InfraredAces/GP2040-CE-Hardware/GP2040 Keyboard Converter/PCB-embedded/assets/PCB-3D.png

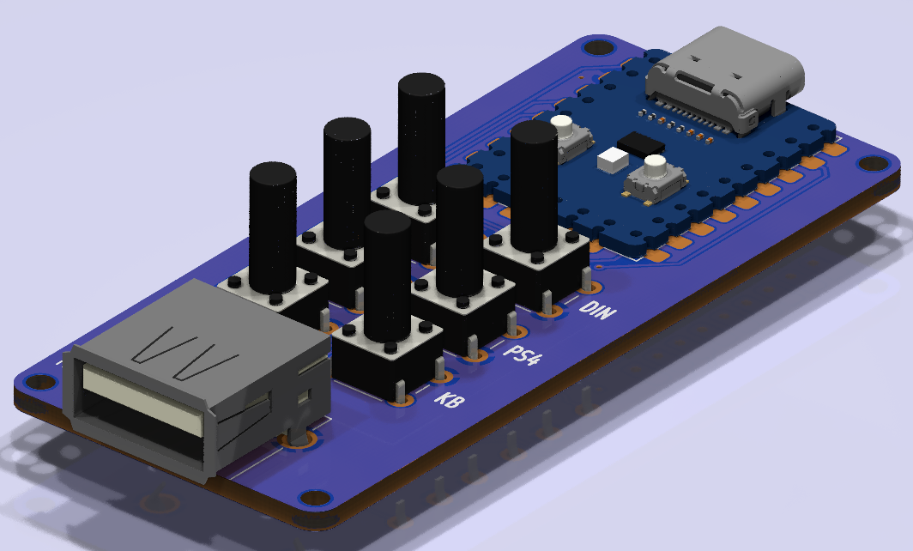
GP2040 Keyboard Converter/PCB-embedded/assets/PCB-3D.png
