InfraredAces/GP2040-CE-Hardware/GP2040 Keyboard Converter/PCB-embedded/case/GP2040-CE Converter Embedded - Bottom.step

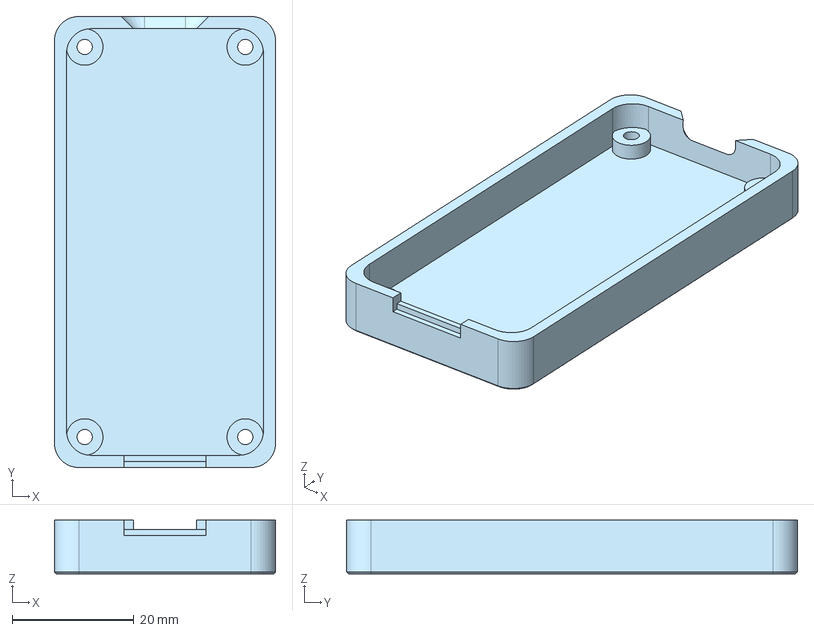
[picture p6: CAD file, 2023-08-12]
GP2040 Keyboard Converter/PCB-embedded/case/GP2040-CE Converter Embedded - Bottom.step
36.3 x 74.0 x 8.80 mm
