InfraredAces/GP2040-CE-Hardware/GP2040 Keyboard Converter/PCB-embedded/kicad/SMF05CT1G/SMF05CT1G.step

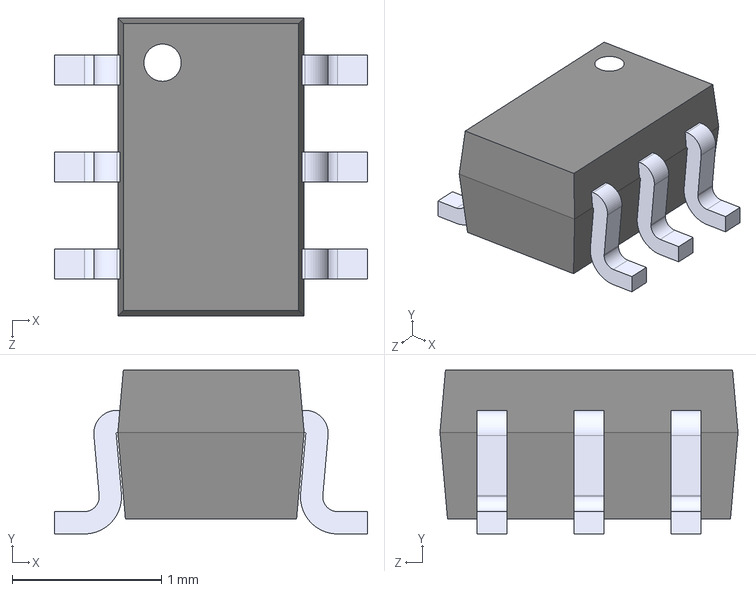
[picture p7: CAD file, 2023-08-12]
GP2040 Keyboard Converter/PCB-embedded/kicad/SMF05CT1G/SMF05CT1G.step
2.10 x 1.10 x 2.00 mm
