InfraredAces/GP2040-CE-Hardware/GP2040 Keyboard Converter/PCB-embedded/case/GP2040-CE Converter Embedded - Top.step

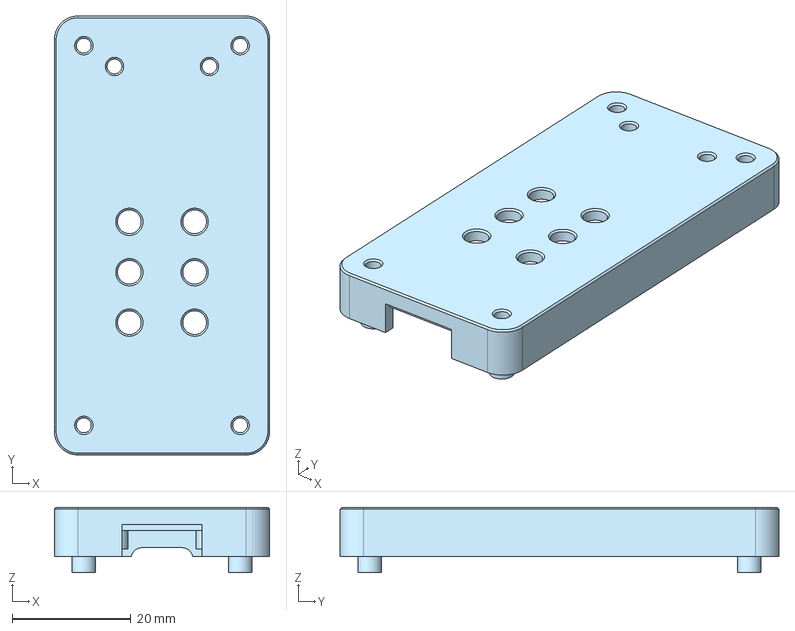
[picture p8: CAD file, 2023-08-12]
GP2040 Keyboard Converter/PCB-embedded/case/GP2040-CE Converter Embedded - Top.step
36.3 x 74.0 x 11.0 mm
