InfraredAces/GP2040-CE-Hardware/(list of files, cad)

Other CAD files:
GP2040 Keyboard Converter/PCB-embedded/case/GP2040-CE Converter Embedded - Bottom.3mf
GP2040 Keyboard Converter/PCB-embedded/case/GP2040-CE Converter Embedded - Bottom.stl
GP2040 Keyboard Converter/PCB-embedded/case/GP2040-CE Converter Embedded - Top.3mf
GP2040 Keyboard Converter/PCB-embedded/case/GP2040-CE Converter Embedded - Top.stl
