InfraredAces/GP2040-CE-Hardware/GP2040 Keyboard Converter/PCB-embedded/kicad/GP2040-Converter.kicad_pcb

## KiCad design GP2040 Keyboard Converter/PCB-embedded/kicad/GP2040-Converter.kicad_pcb (2023-08-12)

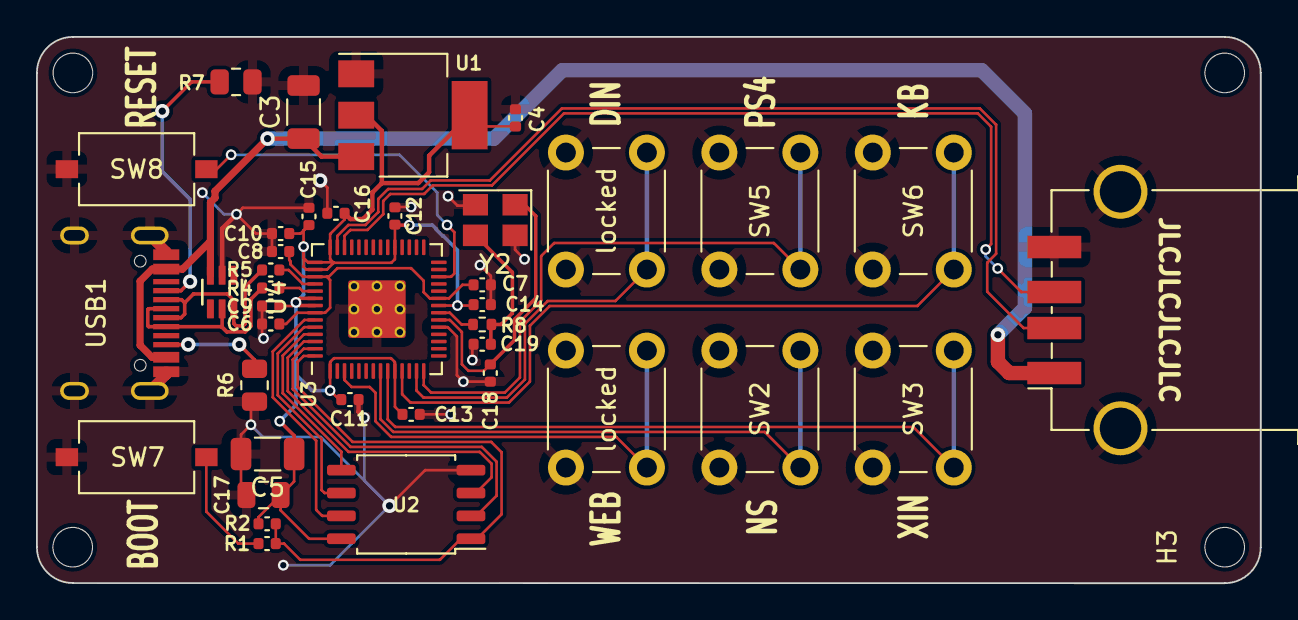
[picture p9: board GP2040-Converter.kicad_pcb from above]

Board: 2 copper layers, 68.0 x 30.4 mm, 43 parts (0 on the bottom side), 29 nets.

Parts:
C3, C5: 10u; C_1206_3216Metric
C4, C6, C7, C9, C11, C12, C13, C14, C15, C16: 100n; C_0402_1005Metric
C8, C10: 1u; C_0402_1005Metric
C17: 10u; C_0805_2012Metric
C18, C19: 30p; C_0402_1005Metric
H1, H2, H3, H4: MountingHole; MountingHole_2.2mm_M2
J1: USB_A; USB_A_TE_292303-7_Horizontal
R1: 1k; C_0402_1005Metric
R2: 10k; C_0402_1005Metric
R4, R5: 27; C_0402_1005Metric
R6, R7: 5.1k; R_0805_2012Metric
R8: 1k; R_0402_1005Metric
SW2, SW3, SW5, SW6: SW_Push_Open; SW_PUSH_6mm_H13mm
SW7, SW8: SW_Push_Open; SW_Tactile_SPST_NO_Straight_CK_PTS636Sx25SMTRLFS
U1: NCP1117-3.3_SOT223; SOT-223-3_TabPin2
U2: W25Q128JVS; SOIC-8_5.23x5.23mm_P1.27mm
U3: RP2040; RP2040-QFN-56
U4: SMF05CT1G; SOT65P210X110-6N
USB1: HRO-TYPE-C-31-M-12; HRO-TYPE-C-31-M-12-Assembly
Y2: Crystal_GND24; Crystal_SMD_3225-4Pin_3.2x2.5mm
locked: locked; SW_PUSH_6mm_H13mm
locked#2: SW_Push_Open; SW_PUSH_6mm_H13mm

Connections:
+1V1: C6.1, C7.1, C8.1, U3.23 (DVDD), U3.45 (VREG_VOUT), U3.50 (DVDD)
+3V3: C4.1, C5.1, C9.1, C10.1, C11.1, C12.1, C13.1, C14.1, C15.1, C16.1, C17.1, R2.1, U1.2 (VO), U2.8 (VCC), U3.1 (IOVDD), U3.10 (IOVDD), U3.22 (IOVDD), U3.33 (IOVDD), U3.42 (IOVDD), U3.43 (ADC_AVDD), U3.44 (VREG_IN), U3.48 (USB_VDD), U3.49 (IOVDD)
+5V: C3.1, J1.1 (VBUS), U1.3 (VI), U4.3, USB1.2 (VBUS), USB1.11 (VBUS)
/QSPI_SCLK: U2.6 (CLK), U3.52 (QSPI_SCLK)
/QSPI_SD0: U2.5 (DI(IO0)), U3.53 (QSPI_SD0)
/QSPI_SD1: U2.2 (DO(IO1)), U3.55 (QSPI_SD1)
/QSPI_SD2: U2.3 (IO2), U3.54 (QSPI_SD2)
/QSPI_SD3: U2.7 (IO3), U3.51 (QSPI_SD3)
/QSPI_SS: R1.1, R2.2, U2.1 (~CS), U3.56 (QSPI_SS)
/RUN: SW8.2 (B), U3.26 (RUN)
/USB_D+: R4.1, U4.5, USB1.6 (DP1), USB1.8 (DP2)
/USB_D-: R5.1, U4.6, USB1.5 (DN2), USB1.7 (DN1)
/XIN: C18.2, U3.20 (XIN), Y2.1
/XOUT: R8.2, U3.21 (XOUT)
/~USB_BOOT: R1.2, SW7.2 (B)
CIRCLE: SW3.1 (A), U3.9 (GPIO7)
CROSS: SW2.1 (A), U3.8 (GPIO6)
D_M: J1.2 (D-), U3.41 (GPIO29_ADC3)
D_P: J1.3 (D+), U3.40 (GPIO28_ADC2)
GND: C3.2, C4.2, C5.2, C6.2, C7.2, C8.2, C9.2, C10.2, C11.2, C12.2, C13.2, C14.2, C15.2, C16.2, C17.2, C18.1, C19.2, J1.4 (GND), J1.5 (Shield), R6.2, R7.2, SW2.2 (B), SW3.2 (B), SW5.2 (B), SW6.2 (B), SW7.1 (A), SW8.1 (A), U1.1 (GND), U2.4 (GND), U3.19 (TESTEN), U3.57 (GND), U4.2, USB1.1 (GND), USB1.12 (GND), USB1.13 (SHIELD), Y2.2, Y2.4, locked.2 (B), locked#2.2 (B)
unnamed: C19.1, R8.1, Y2.3
unnamed: R5.2, U3.46 (USB_DM)
unnamed: R4.2, U3.47 (USB_DP)
unnamed: R7.1, USB1.4 (CC1)
unnamed: R6.1, USB1.10 (CC2)
OPTION: U3.3 (GPIO1), locked#2.1 (A)
R2: SW6.1 (A), U3.11 (GPIO8)
SQUARE: U3.13 (GPIO10), locked.1 (A)
TRIANGLE: SW5.1 (A), U3.14 (GPIO11)
